mAzurkovic/foc/hw/foc_controller.kicad_pcb

## KiCad design hw/foc_controller.kicad_pcb (2026-10-27)

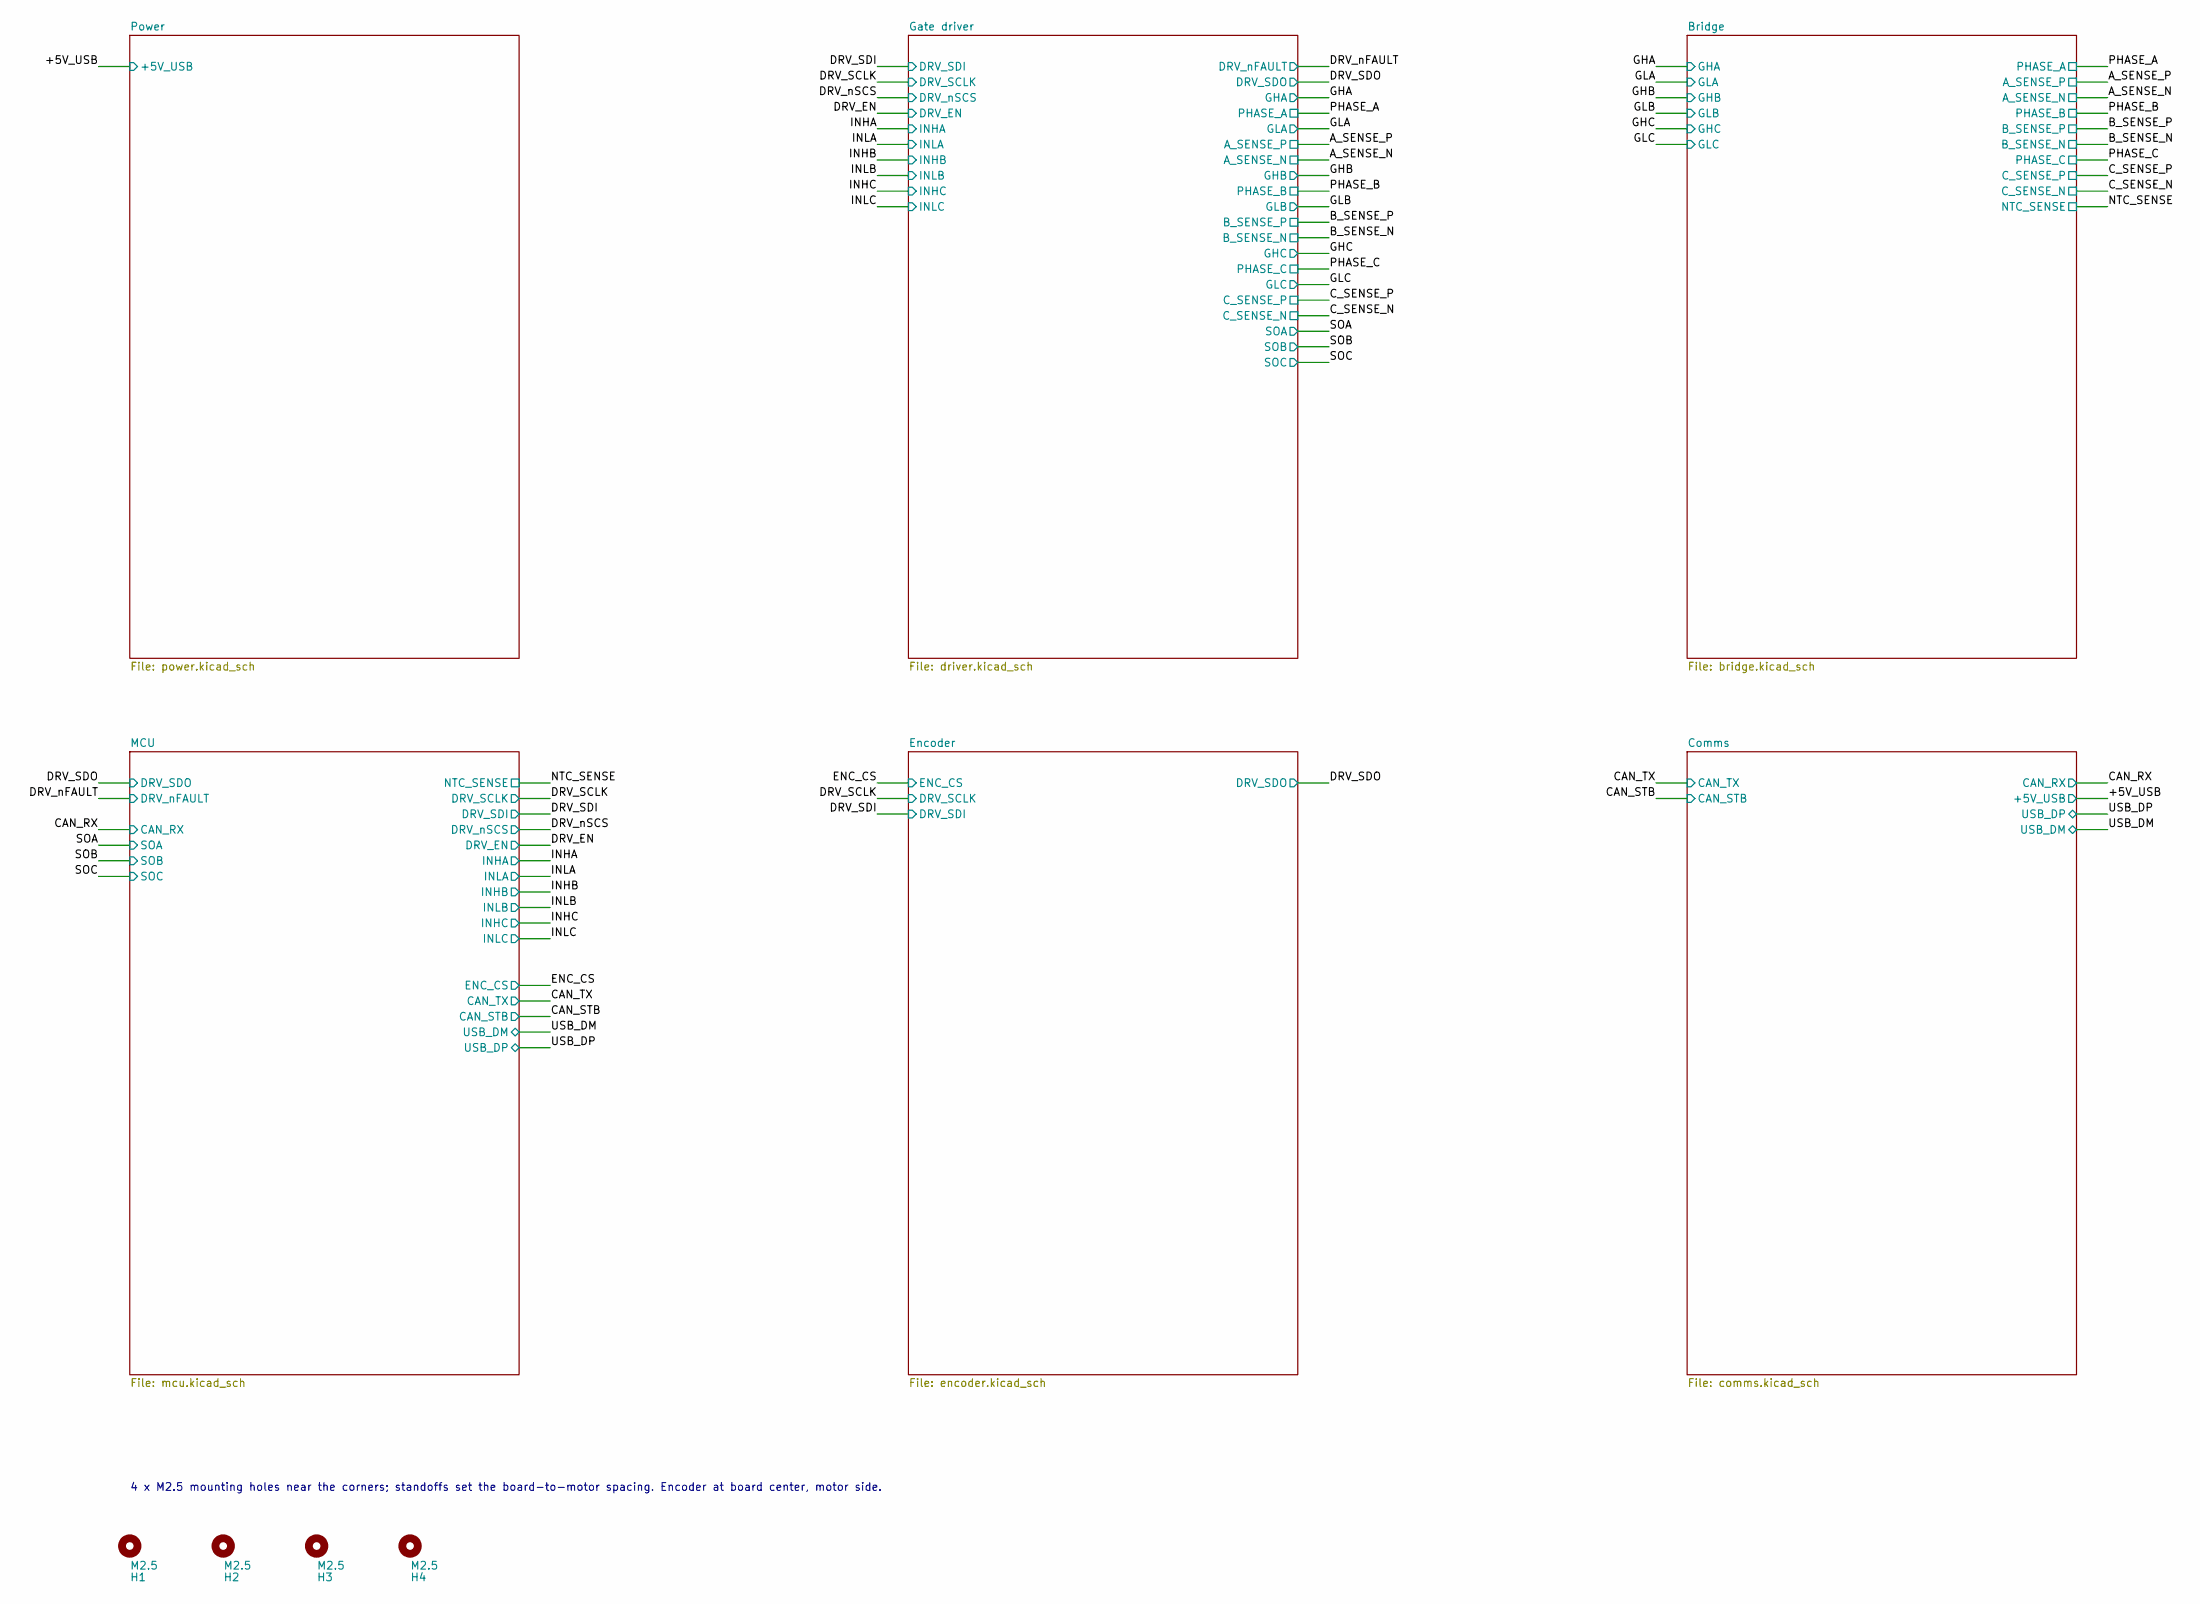
[picture p1: schematic foc_controller.kicad_sch, FOC controller: block diagram]

Parts:
H1, H2, H3, H4: M2.5; MountingHole_2.7mm_M2.5

Notes on the sheet:
4 x M2.5 mounting holes near the corners; standoffs set the board-to-motor spacing. Encoder at board center, motor side.

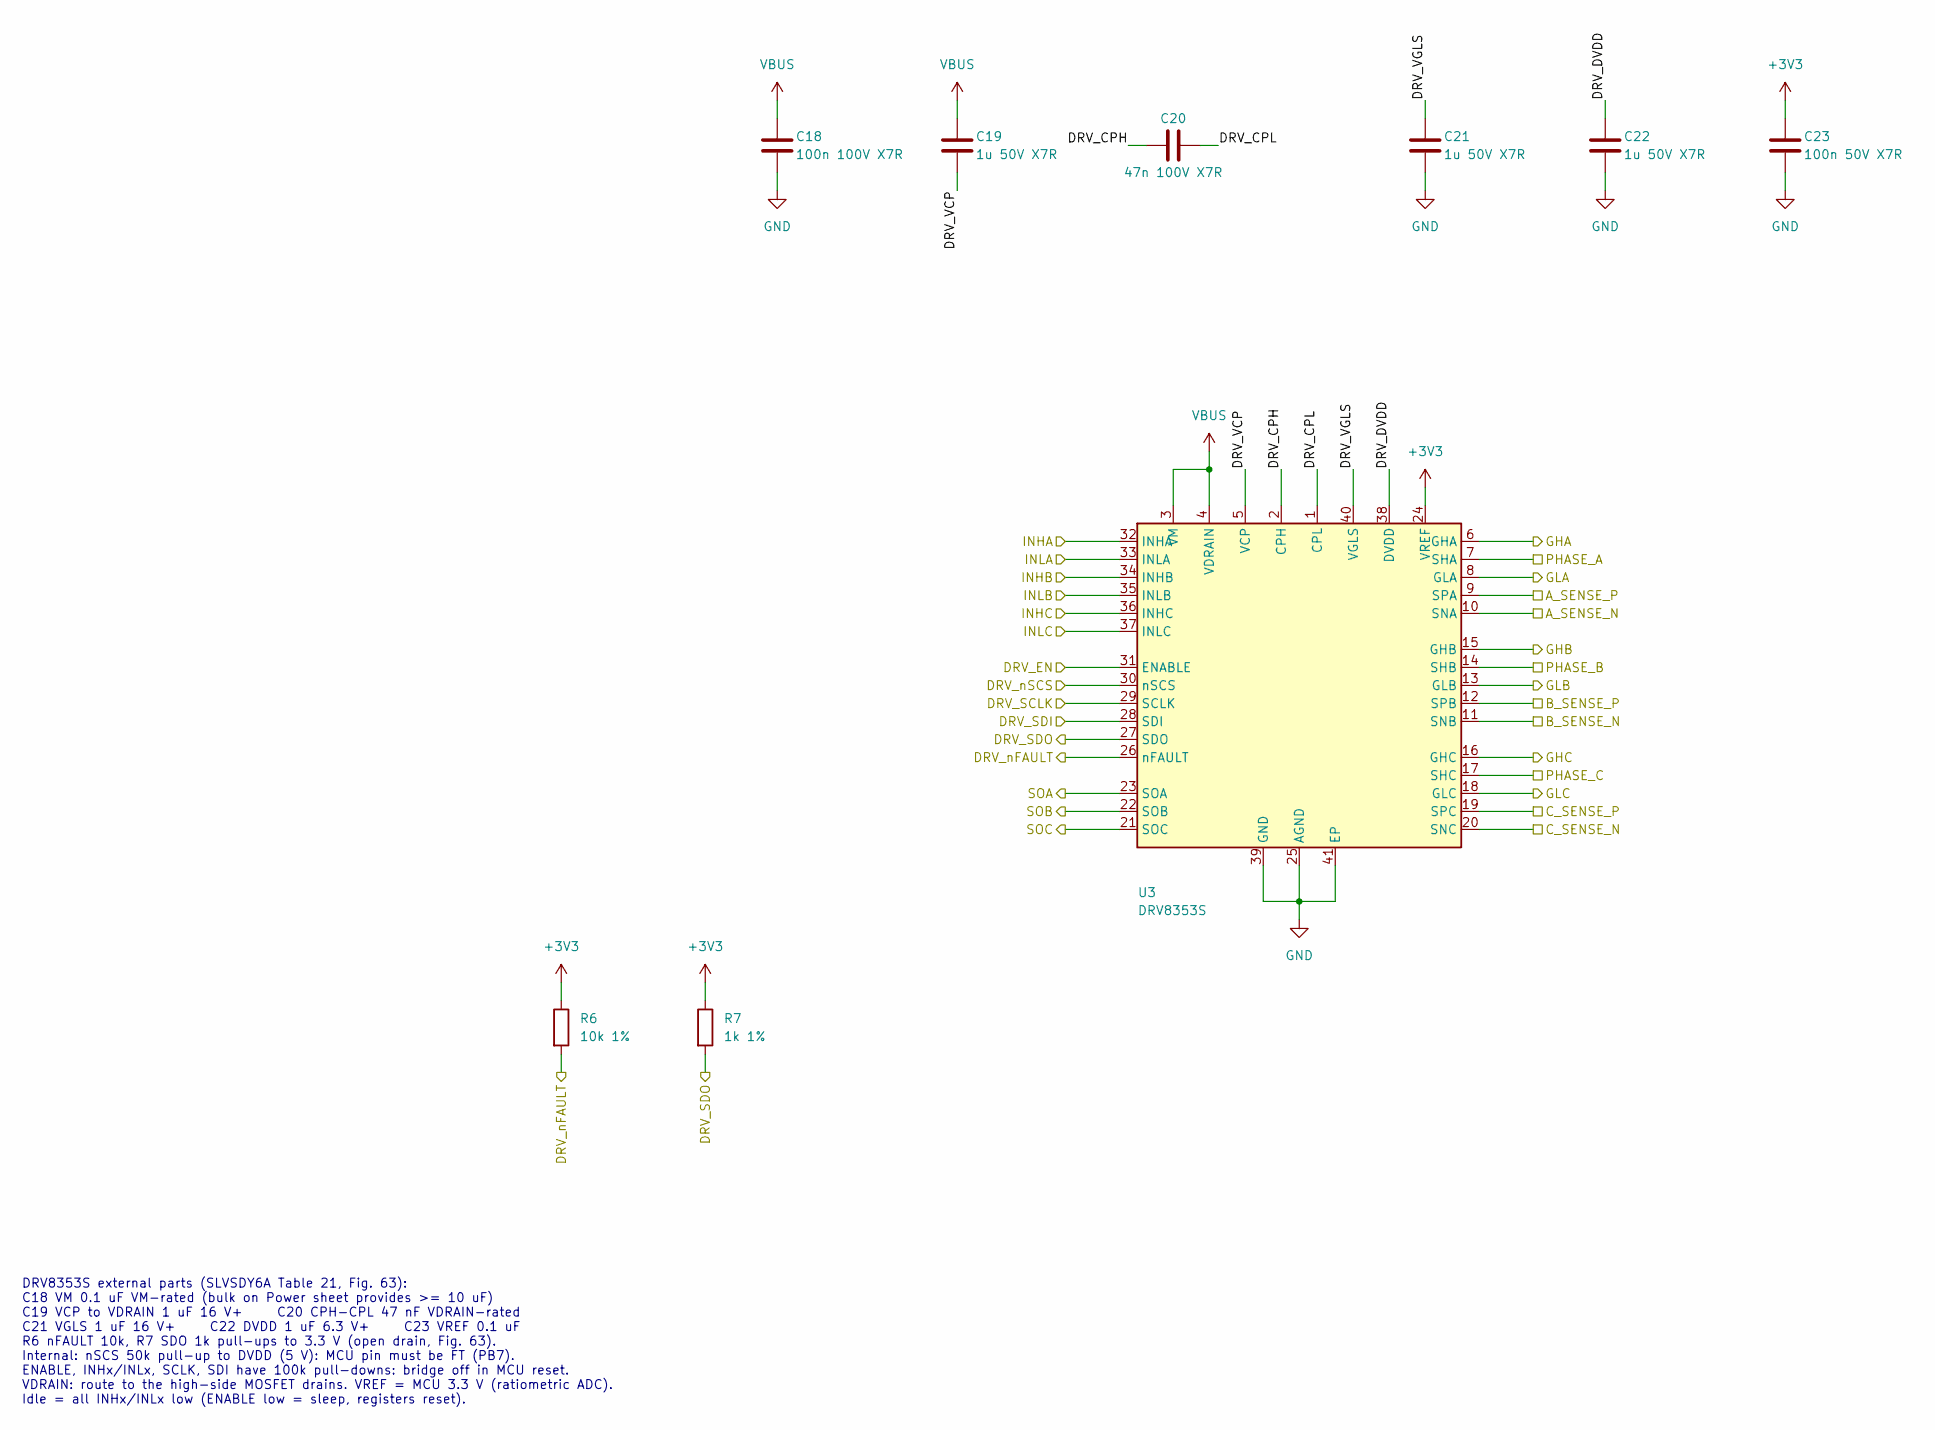
[picture p2: schematic driver.kicad_sch, Gate driver DRV8353S]

Parts:
C18: 100n 100V X7R; C_0603_1608Metric; MPN CC0603KRX7R0BB104; LCSC C113803
C19, C21, C22: 1u 50V X7R; C_0805_2012Metric; MPN CL21B105KBFNNNE; LCSC C28323
C20: 47n 100V X7R; C_0805_2012Metric; MPN CL21B473KCFNNNE; LCSC C17074
C23: 100n 50V X7R; C_0402_1005Metric; MPN CL05B104KB54PNC; LCSC C307331
R6: 10k 1%; R_0402_1005Metric; MPN 0402WGF1002TCE; LCSC C25744
R7: 1k 1%; R_0402_1005Metric; MPN 0402WGF1001TCE; LCSC C11702
U3: DRV8353S; WQFN-40_L6.0-W6.0-P0.50-TL-EP4.2; MPN DRV8353SRTAT; LCSC C2150480

Connections:
+3V3: C23.1, R6.1, R7.1, U3.24 (VREF); also elsewhere on the board
/A_SENSE_N: U3.10 (SNA); also elsewhere on the board
/A_SENSE_P: U3.9 (SPA); also elsewhere on the board
/B_SENSE_N: U3.11 (SNB); also elsewhere on the board
/B_SENSE_P: U3.12 (SPB); also elsewhere on the board
/C_SENSE_N: U3.20 (SNC); also elsewhere on the board
/C_SENSE_P: U3.19 (SPC); also elsewhere on the board
/DRV_EN: U3.31 (ENABLE); also elsewhere on the board
/DRV_SCLK: U3.29 (SCLK); also elsewhere on the board
/DRV_SDI: U3.28 (SDI); also elsewhere on the board
/DRV_SDO: R7.2, U3.27 (SDO); also elsewhere on the board
/DRV_nFAULT: R6.2, U3.26 (nFAULT); also elsewhere on the board
/DRV_nSCS: U3.30 (nSCS); also elsewhere on the board
/GHA: U3.6 (GHA); also elsewhere on the board
/GHB: U3.15 (GHB); also elsewhere on the board
/GHC: U3.16 (GHC); also elsewhere on the board
/GLA: U3.8 (GLA); also elsewhere on the board
/GLB: U3.13 (GLB); also elsewhere on the board
/GLC: U3.18 (GLC); also elsewhere on the board
/Gate driver/DRV_CPH: C20.1, U3.2 (CPH)
/Gate driver/DRV_CPL: C20.2, U3.1 (CPL)
/Gate driver/DRV_DVDD: C22.1, U3.38 (DVDD)
/Gate driver/DRV_VCP: C19.1, U3.5 (VCP)
/Gate driver/DRV_VGLS: C21.1, U3.40 (VGLS)
/INHA: U3.32 (INHA); also elsewhere on the board
/INHB: U3.34 (INHB); also elsewhere on the board
/INHC: U3.36 (INHC); also elsewhere on the board
/INLA: U3.33 (INLA); also elsewhere on the board
/INLB: U3.35 (INLB); also elsewhere on the board
/INLC: U3.37 (INLC); also elsewhere on the board
/PHASE_A: U3.7 (SHA); also elsewhere on the board
/PHASE_B: U3.14 (SHB); also elsewhere on the board
/PHASE_C: U3.17 (SHC); also elsewhere on the board
/SOA: U3.23 (SOA); also elsewhere on the board
/SOB: U3.22 (SOB); also elsewhere on the board
/SOC: U3.21 (SOC); also elsewhere on the board
GND: C18.2, C21.2, C22.2, C23.2, U3.25 (AGND), U3.39 (GND), U3.41 (EP); also elsewhere on the board
VBUS: C18.1, C19.2, U3.3 (VM), U3.4 (VDRAIN); also elsewhere on the board

Notes on the sheet:
DRV8353S external parts (SLVSDY6A Table 21, Fig. 63): C18 VM 0.1 uF VM-rated (bulk on Power sheet provides >= 10 uF) C19 VCP to VDRAIN 1 uF 16 V+ C20 CPH-CPL 47 nF VDRAIN-rated C21 VGLS 1 uF 16 V+ C22 DVDD 1 uF 6.3 V+ C23 VREF 0.1 uF R6 nFAULT 10k, R7 SDO 1k pull-ups to 3.3 V (open drain, Fig. 63).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

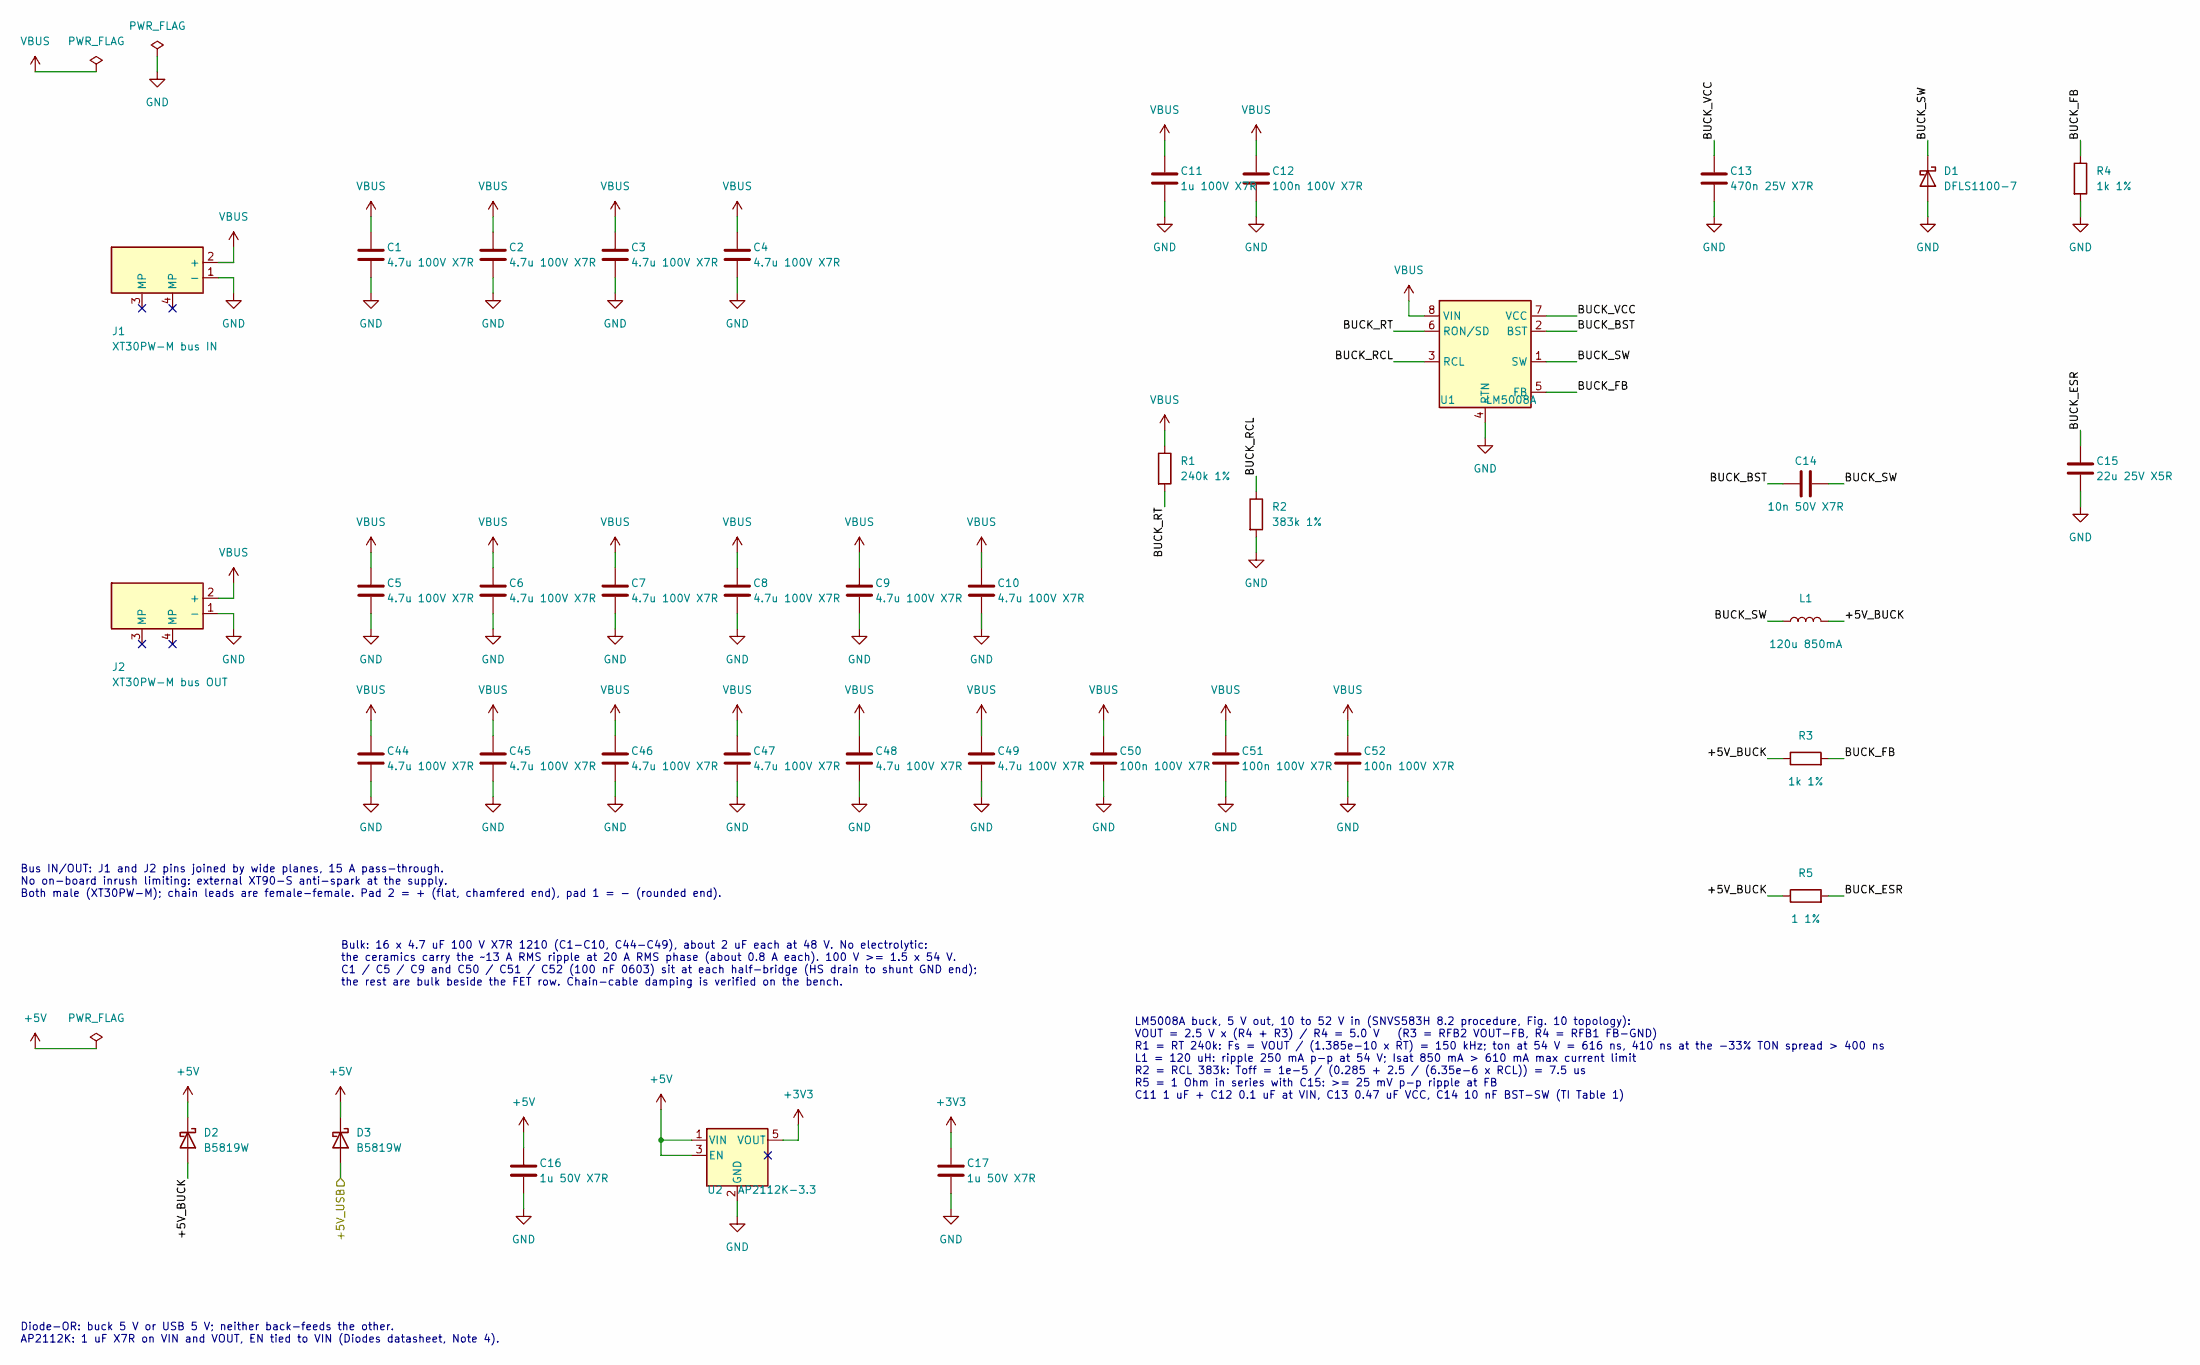
[picture p3: schematic power.kicad_sch, Power input, bulk capacitance, logic supply]

Parts:
C1, C2, C3, C4, C5, C6, C7, C8, C9, C10, C44, C45, C46, C47, C48, C49: 4.7u 100V X7R; C_1210_3225Metric; MPN FS32X475K101EGG; LCSC C381466
C11: 1u 100V X7R; C_1206_3216Metric; MPN CC1206KKX7R0BB105; LCSC C70463
C12, C50, C51, C52: 100n 100V X7R; C_0603_1608Metric; MPN CC0603KRX7R0BB104; LCSC C113803
C13: 470n 25V X7R; C_0603_1608Metric; MPN CL10B474KA8NNNC; LCSC C1623
C14: 10n 50V X7R; C_0603_1608Metric; MPN 0603B103K500NT; LCSC C57112
C15: 22u 25V X5R; C_1206_3216Metric; MPN CL31A226KAHNNNE; LCSC C12891
C16, C17: 1u 50V X7R; C_0805_2012Metric; MPN CL21B105KBFNNNE; LCSC C28323
D1: DFLS1100-7; D_PowerDI-123; MPN DFLS1100-7; LCSC C107674
D2, D3: B5819W; D_SOD-123; MPN B5819W SL; LCSC C8598
J1: XT30PW-M bus IN; CONN-TH_XT30PW-M-1; MPN XT30PW-M30.G.Y; LCSC C431092
J2: XT30PW-M bus OUT; CONN-TH_XT30PW-M-1; MPN XT30PW-M30.G.Y; LCSC C431092
L1: 120u 850mA; IND-SMD_L6.0-W6.0; MPN SWPA6045S121MT; LCSC C96952
R1: 240k 1%; R_0603_1608Metric; MPN RC0603FR-07240KL; LCSC C137765
R2: 383k 1%; R_0603_1608Metric; MPN 0603WAF3833T5E; LCSC C25816
R3, R4: 1k 1%; R_0402_1005Metric; MPN 0402WGF1001TCE; LCSC C11702
R5: 1 1%; R_0603_1608Metric; MPN 0603WAF100KT5E; LCSC C22936
U1: LM5008A; MSOP-8_3x3mm_P0.65mm; MPN LM5008AMMX/NOPB; LCSC C2071250
U2: AP2112K-3.3; SOT-23-5; MPN AP2112K-3.3TRG1; LCSC C51118

Connections:
+3V3: C17.1, U2.5 (VOUT); also elsewhere on the board
+5V: C16.1, D2.1 (K), D3.1 (K), U2.1 (VIN), U2.3 (EN)
/+5V_USB: D3.2 (A); also elsewhere on the board
/Power/+5V_BUCK: D2.2 (A), L1.2, R3.1, R5.1
/Power/BUCK_BST: C14.1, U1.2 (BST)
/Power/BUCK_ESR: C15.1, R5.2
/Power/BUCK_FB: R3.2, R4.1, U1.5 (FB)
/Power/BUCK_RCL: R2.1, U1.3 (RCL)
/Power/BUCK_RT: R1.2, U1.6 (RON/SD)
/Power/BUCK_SW: C14.2, D1.1 (K), L1.1, U1.1 (SW)
/Power/BUCK_VCC: C13.1, U1.7 (VCC)
GND: C1.2, C2.2, C3.2, C4.2, C5.2, C6.2, C7.2, C8.2, C9.2, C10.2, C11.2, C12.2, C13.2, C15.2, C16.2, C17.2, C44.2, C45.2, C46.2, C47.2, C48.2, C49.2, C50.2, C51.2, C52.2, D1.2 (A), J1.1 (-), J2.1 (-), R2.2, R4.2, U1.4 (RTN), U2.2 (GND); also elsewhere on the board
VBUS: C1.1, C2.1, C3.1, C4.1, C5.1, C6.1, C7.1, C8.1, C9.1, C10.1, C11.1, C12.1, C44.1, C45.1, C46.1, C47.1, C48.1, C49.1, C50.1, C51.1, C52.1, J1.2 (+), J2.2 (+), R1.1, U1.8 (VIN); also elsewhere on the board

Notes on the sheet:
Diode-OR: buck 5 V or USB 5 V; neither back-feeds the other. AP2112K: 1 uF X7R on VIN and VOUT, EN tied to VIN (Diodes datasheet, Note 4).
Bus IN/OUT: J1 and J2 pins joined by wide planes, 15 A pass-through. No on-board inrush limiting: external XT90-S anti-spark at the supply. Both male (XT30PW-M); chain leads are female-female. Pad 2 = + (flat, chamfered end), pad 1 = - (rounded end).
LM5008A buck, 5 V out, 10 to 52 V in (SNVS583H 8.2 procedure, Fig. 10 topology): VOUT = 2.5 V x (R4 + R3) / R4 = 5.0 V (R3 = RFB2 VOUT-FB, R4 = RFB1 FB-GND) R1 = RT 240k: Fs = VOUT / (1.385e-10 x RT) = 150 kHz; ton at 54 V = 616 ns, 410 ns at the -33% TON spread > 400 ns L1 = 120 uH: ripple 250 mA 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
Bulk: 16 x 4.7 uF 100 V X7R 1210 (C1-C10, C44-C49), about 2 uF each at 48 V. No electrolytic: the ceramics carry the ~13 A RMS ripple at 20 A RMS phase (about 0.8 A each). 100 V >= 1.5 x 54 V. C1 / C5 / C9 and C50 / C51 / C52 (100 nF 0603) sit at each half-bridge (HS drain to shunt GND end); the re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

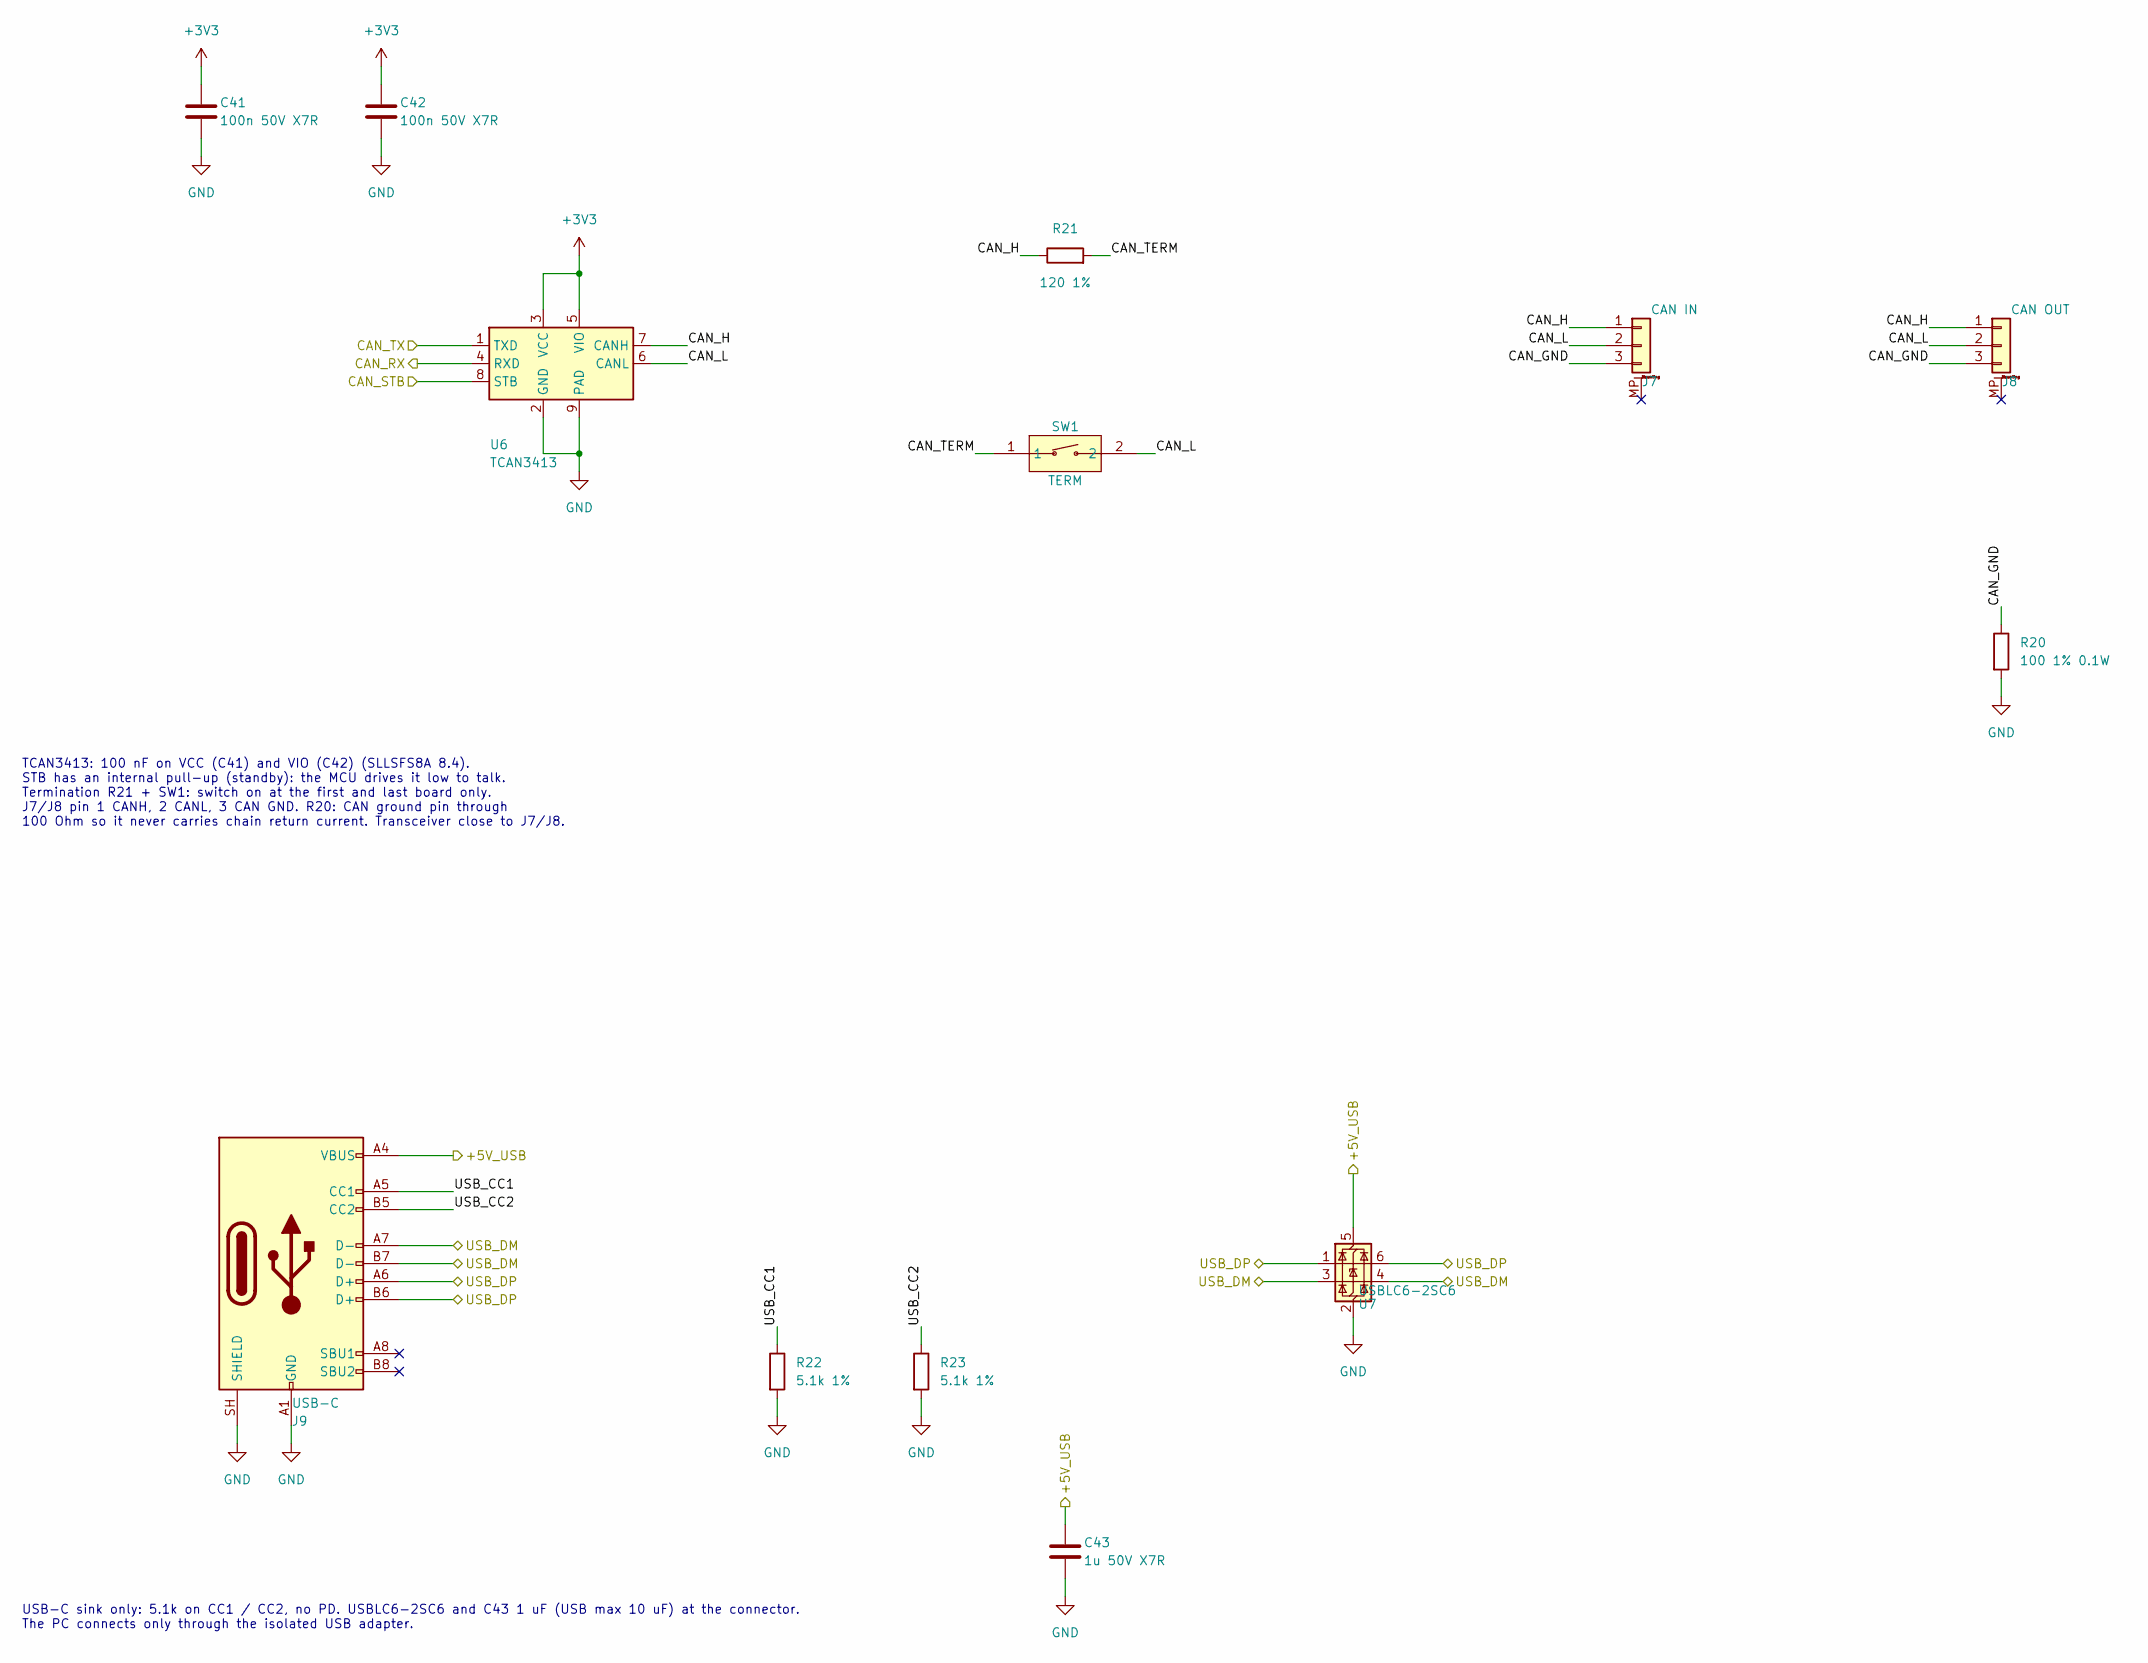
[picture p4: schematic comms.kicad_sch, CAN FD daisy chain and USB-C]

Parts:
C41, C42: 100n 50V X7R; C_0402_1005Metric; MPN CL05B104KB54PNC; LCSC C307331
C43: 1u 50V X7R; C_0805_2012Metric; MPN CL21B105KBFNNNE; LCSC C28323
J7: CAN IN; JST_GH_SM03B-GHS-TB_1x03-1MP_P1.25mm_Horizontal; MPN SM03B-GHS-TB(LF)(SN); LCSC C514175
J8: CAN OUT; JST_GH_SM03B-GHS-TB_1x03-1MP_P1.25mm_Horizontal; MPN SM03B-GHS-TB(LF)(SN); LCSC C514175
J9: USB-C; USB_C_Receptacle_HRO_TYPE-C-31-M-12; MPN TYPE-C-31-M-12; LCSC C165948
R20: 100 1% 0.1W; R_0603_1608Metric; MPN 0603WAF1000T5E; LCSC C22775
R21: 120 1%; R_0603_1608Metric; MPN 0603WAF1200T5E; LCSC C22787
R22, R23: 5.1k 1%; R_0402_1005Metric; MPN 0402WGF5101TCE; LCSC C25905
SW1: TERM; SW-SMD_1.27-1P-TPPT; MPN 1.27-1P TPPT; LCSC C6386918
U6: TCAN3413; SON-8_L3.0-W3.0-P0.65-LS2.9-BL-EP; MPN TCAN3413DRBR; LCSC C22445415
U7: USBLC6-2SC6; SOT-23-6; MPN USBLC6-2SC6; LCSC C2687116

Connections:
+3V3: C41.1, C42.1, U6.3 (VCC), U6.5 (VIO); also elsewhere on the board
/+5V_USB: C43.1, J9.A4 (VBUS), J9.A9 (VBUS), J9.B4 (VBUS), J9.B9 (VBUS), U7.5 (VBUS); also elsewhere on the board
/CAN_RX: U6.4 (RXD); also elsewhere on the board
/CAN_STB: U6.8 (STB); also elsewhere on the board
/CAN_TX: U6.1 (TXD); also elsewhere on the board
/Comms/CAN_GND: J7.3, J8.3, R20.1; also elsewhere on the board
/Comms/CAN_H: J7.1, J8.1, R21.1, U6.7 (CANH); also elsewhere on the board
/Comms/CAN_L: J7.2, J8.2, SW1.2, U6.6 (CANL); also elsewhere on the board
/Comms/USB_CC1: J9.A5 (CC1), R22.1
/Comms/USB_CC2: J9.B5 (CC2), R23.1
/USB_DM: J9.A7 (D-), J9.B7 (D-), U7.3 (I/O2), U7.4 (I/O2); also elsewhere on the board
/USB_DP: J9.A6 (D+), J9.B6 (D+), U7.1 (I/O1), U7.6 (I/O1); also elsewhere on the board
GND: C41.2, C42.2, C43.2, J9.A1 (GND), J9.A12 (GND), J9.B1 (GND), J9.B12 (GND), J9.SH (SHIELD), R20.2, R22.2, R23.2, U6.2 (GND), U6.9 (PAD), U7.2 (GND); also elsewhere on the board
unnamed: R21.2, SW1.1

Notes on the sheet:
TCAN3413: 100 nF on VCC (C41) and VIO (C42) (SLLSFS8A 8.4). STB has an internal pull-up (standby): the MCU drives it low to talk. Termination R21 + SW1: switch on at the first and last board only. J7/J8 pin 1 CANH, 2 CANL, 3 CAN GND. R20: CAN ground pin through 100 Ohm so it never carries chain ret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
USB-C sink only: 5.1k on CC1 / CC2, no PD. USBLC6-2SC6 and C43 1 uF (USB max 10 uF) at the connector. The PC connects only through the isolated USB adapter.

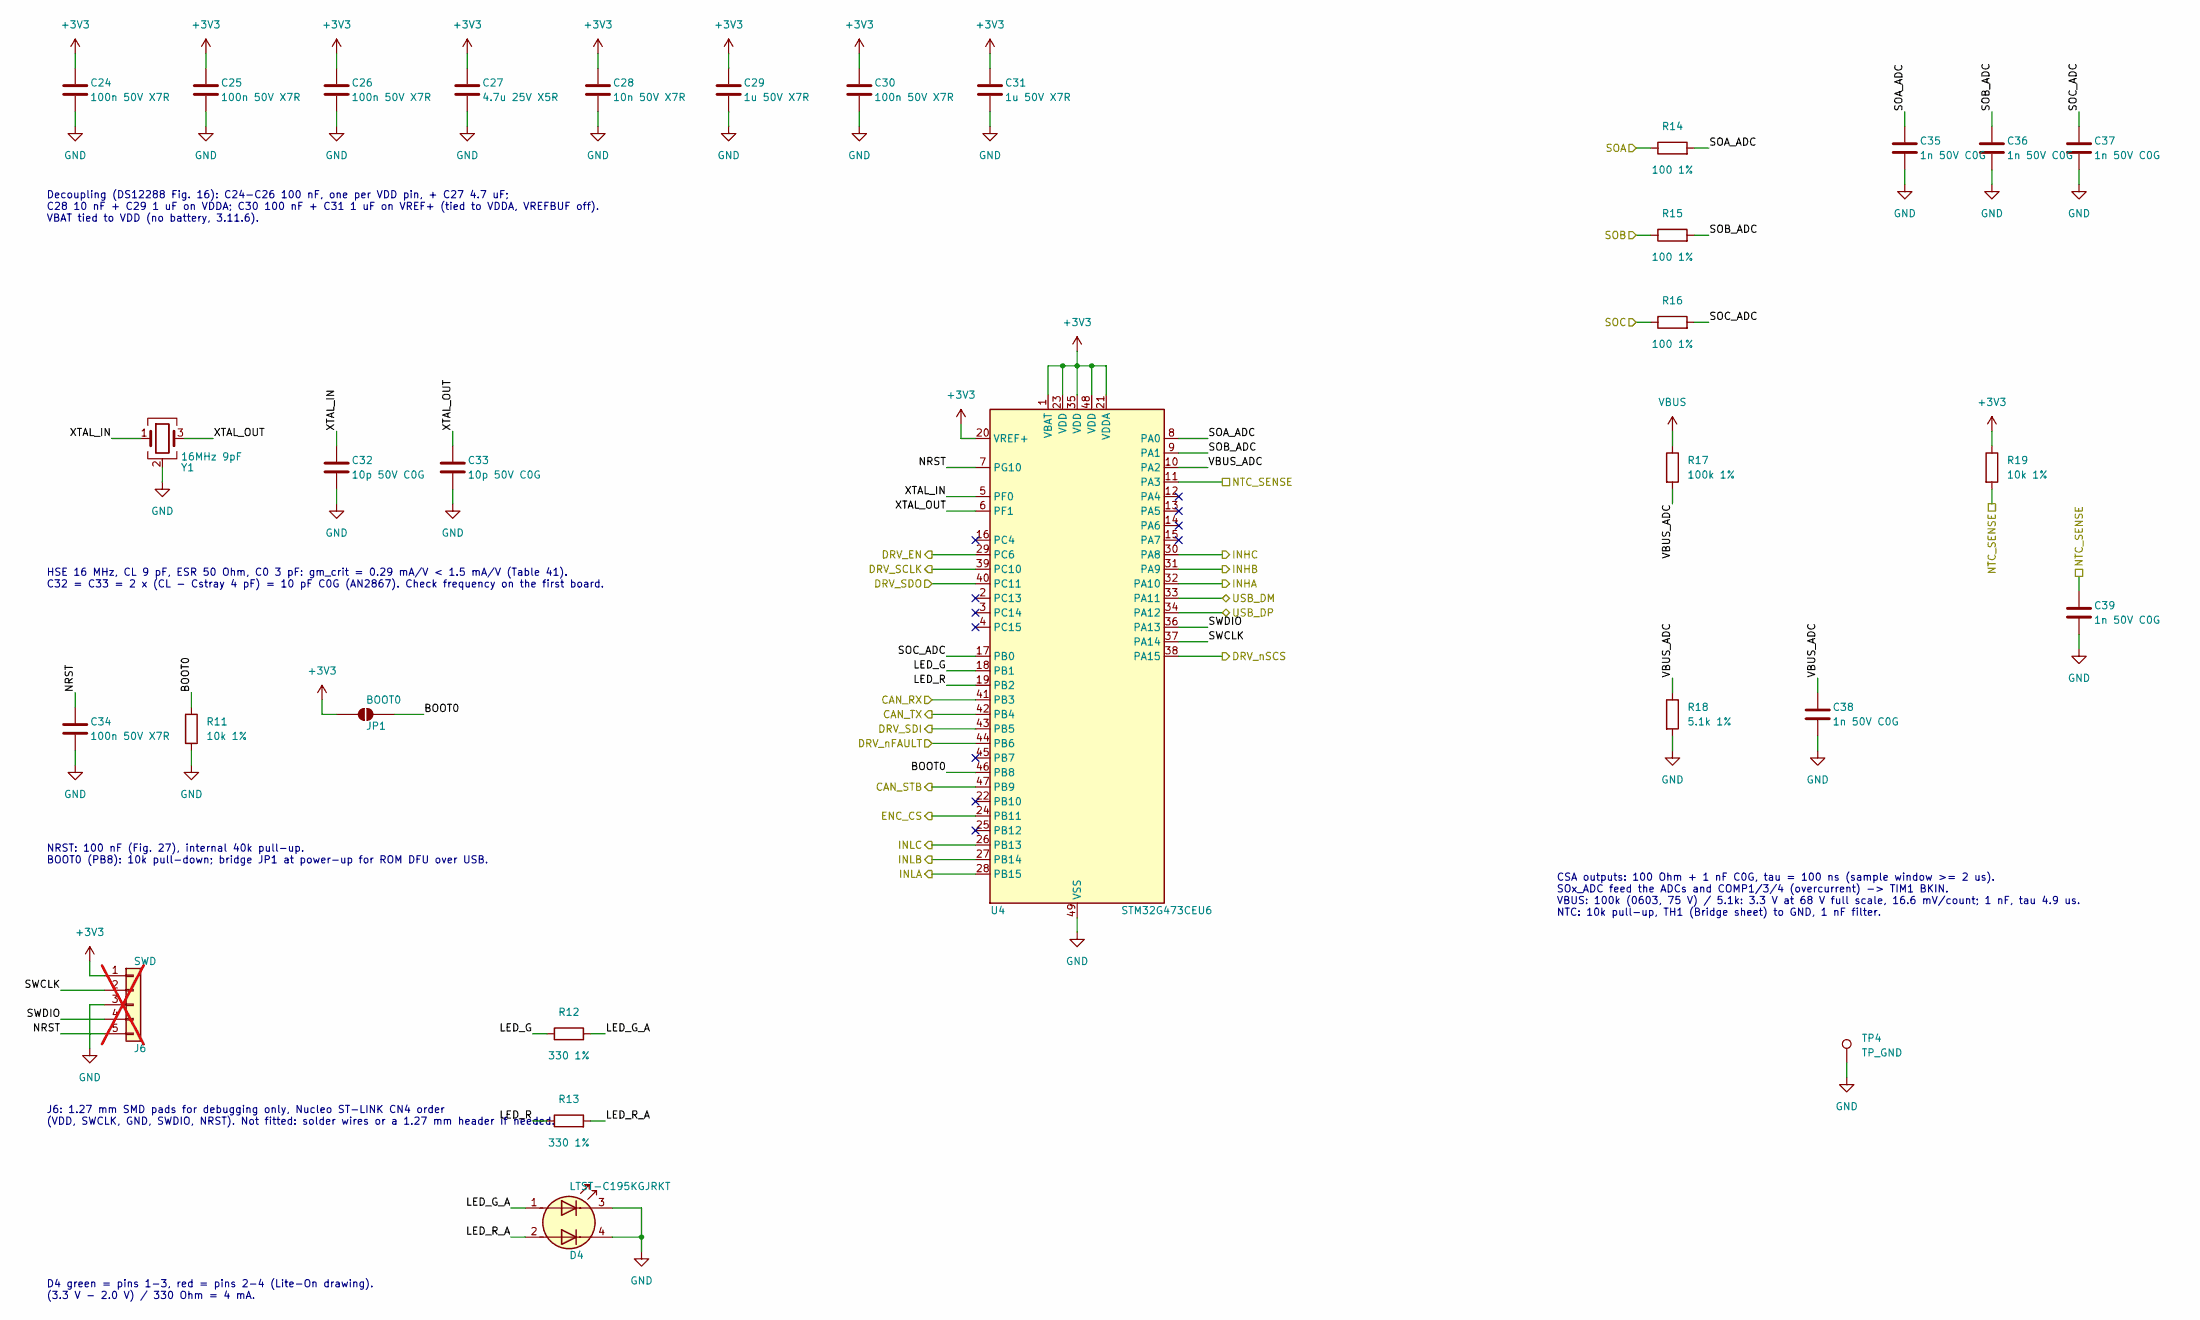
[picture p5: schematic mcu.kicad_sch, MCU STM32G473]

Parts:
C24, C25, C26, C30, C34: 100n 50V X7R; C_0402_1005Metric; MPN CL05B104KB54PNC; LCSC C307331
C27: 4.7u 25V X5R; C_0805_2012Metric; MPN CL21A475KAQNNNE; LCSC C1779
C28: 10n 50V X7R; C_0402_1005Metric; MPN CL05B103KB5NNNC; LCSC C15195
C29, C31: 1u 50V X7R; C_0805_2012Metric; MPN CL21B105KBFNNNE; LCSC C28323
C32, C33: 10p 50V C0G; C_0402_1005Metric; MPN CL05C100JB5NNNC; LCSC C32949
C35, C36, C37, C38, C39: 1n 50V C0G; C_0402_1005Metric; MPN CC0402JRNPO9BN102; LCSC C113780
D4: LTST-C195KGJRKT; LED-ARRAY-SMD_0603-4P-L1.6-W1.5-BR-RD; MPN LTST-C195KGJRKT; LCSC C125104
J6: SWD; SWD_Pads_1x05_P1.27mm_SMD; not fitted
JP1: BOOT0; SolderJumper-2_P1.3mm_Open_Pad1.0x1.5mm
R11, R19: 10k 1%; R_0402_1005Metric; MPN 0402WGF1002TCE; LCSC C25744
R12, R13: 330 1%; R_0402_1005Metric; MPN 0402WGF3300TCE; LCSC C25104
R14, R15, R16: 100 1%; R_0402_1005Metric; MPN 0402WGF1000TCE; LCSC C25076
R17: 100k 1%; R_0603_1608Metric; MPN 0603WAF1003T5E; LCSC C25803
R18: 5.1k 1%; R_0603_1608Metric; MPN 0603WAF5101T5E; LCSC C23186
TP4: TP_GND; TestPoint_Pad_D1.0mm
U4: STM32G473CEU6; QFN-48-1EP_7x7mm_P0.5mm_EP5.6x5.6mm; MPN STM32G473CEU6; LCSC C1342773
Y1: 16MHz 9pF; Crystal_SMD_3225-4Pin_3.2x2.5mm; MPN X322516MLB4SI; LCSC C13738

Connections:
+3V3: C24.1, C25.1, C26.1, C27.1, C28.1, C29.1, C30.1, C31.1, J6.1, JP1.1 (A), R19.1, U4.1 (VBAT), U4.20 (VREF+), U4.21 (VDDA), U4.23 (VDD), U4.35 (VDD), U4.48 (VDD); also elsewhere on the board
/CAN_RX: U4.41 (PB3); also elsewhere on the board
/CAN_STB: U4.47 (PB9); also elsewhere on the board
/CAN_TX: U4.42 (PB4); also elsewhere on the board
/DRV_EN: U4.29 (PC6); also elsewhere on the board
/DRV_SCLK: U4.39 (PC10); also elsewhere on the board
/DRV_SDI: U4.43 (PB5); also elsewhere on the board
/DRV_SDO: U4.40 (PC11); also elsewhere on the board
/DRV_nFAULT: U4.44 (PB6); also elsewhere on the board
/DRV_nSCS: U4.38 (PA15); also elsewhere on the board
/ENC_CS: U4.24 (PB11); also elsewhere on the board
/INHA: U4.32 (PA10); also elsewhere on the board
/INHB: U4.31 (PA9); also elsewhere on the board
/INHC: U4.30 (PA8); also elsewhere on the board
/INLA: U4.28 (PB15); also elsewhere on the board
/INLB: U4.27 (PB14); also elsewhere on the board
/INLC: U4.26 (PB13); also elsewhere on the board
/MCU/BOOT0: JP1.2 (B), R11.1, U4.46 (PB8)
/MCU/LED_G: R12.1, U4.18 (PB1)
/MCU/LED_G_A: D4.1 (A1), R12.2
/MCU/LED_R: R13.1, U4.19 (PB2)
/MCU/LED_R_A: D4.2 (A2), R13.2
/MCU/NRST: C34.1, J6.5, U4.7 (PG10); also elsewhere on the board
/MCU/SOA_ADC: C35.1, R14.2, U4.8 (PA0)
/MCU/SOB_ADC: C36.1, R15.2, U4.9 (PA1)
/MCU/SOC_ADC: C37.1, R16.2, U4.17 (PB0)
/MCU/SWCLK: J6.2, U4.37 (PA14); also elsewhere on the board
/MCU/SWDIO: J6.4, U4.36 (PA13); also elsewhere on the board
/MCU/VBUS_ADC: C38.1, R17.2, R18.1, U4.10 (PA2)
/MCU/XTAL_IN: C32.1, U4.5 (PF0), Y1.1
/MCU/XTAL_OUT: C33.1, U4.6 (PF1), Y1.3
/NTC_SENSE: C39.1, R19.2, U4.11 (PA3); also elsewhere on the board
/SOA: R14.1; also elsewhere on the board
/SOB: R15.1; also elsewhere on the board
/SOC: R16.1; also elsewhere on the board
/USB_DM: U4.33 (PA11); also elsewhere on the board
/USB_DP: U4.34 (PA12); also elsewhere on the board
GND: C24.2, C25.2, C26.2, C27.2, C28.2, C29.2, C30.2, C31.2, C32.2, C33.2, C34.2, C35.2, C36.2, C37.2, C38.2, C39.2, D4.3 (K1), D4.4 (K2), J6.3, R11.2, R18.2, TP4.1 (1_1), U4.49 (VSS), Y1.2 (G), Y1.4 (G); also elsewhere on the board
VBUS: R17.1; also elsewhere on the board

Notes on the sheet:
Decoupling (DS12288 Fig. 16): C24-C26 100 nF, one per VDD pin, + C27 4.7 uF; C28 10 nF + C29 1 uF on VDDA; C30 100 nF + C31 1 uF on VREF+ (tied to VDDA, VREFBUF off). VBAT tied to VDD (no battery, 3.11.6).
HSE 16 MHz, CL 9 pF, ESR 50 Ohm, C0 3 pF: gm_crit = 0.29 mA/V < 1.5 mA/V (Table 41). C32 = C33 = 2 x (CL - Cstray 4 pF) = 10 pF C0G (AN2867). Check frequency on the first board.
CSA outputs: 100 Ohm + 1 nF C0G, tau = 100 ns (sample window >= 2 us). SOx_ADC feed the ADCs and COMP1/3/4 (overcurrent) -> TIM1 BKIN. VBUS: 100k (0603, 75 V) / 5.1k: 3.3 V at 68 V full scale, 16.6 mV/count; 1 nF, tau 4.9 us. NTC: 10k pull-up, TH1 (Bridge sheet) to GND, 1 nF filter.
D4 green = pins 1-3, red = pins 2-4 (Lite-On drawing). (3.3 V - 2.0 V) / 330 Ohm = 4 mA.
J6: 1.27 mm SMD pads for debugging only, Nucleo ST-LINK CN4 order (VDD, SWCLK, GND, SWDIO, NRST). Not fitted: solder wires or a 1.27 mm header if needed.
NRST: 100 nF (Fig. 27), internal 40k pull-up. BOOT0 (PB8): 10k pull-down; bridge JP1 at power-up for ROM DFU over USB.
