mAzurkovic/foc/hw/foc_controller.kicad_pcb

## KiCad design hw/foc_controller.kicad_pcb (continued)

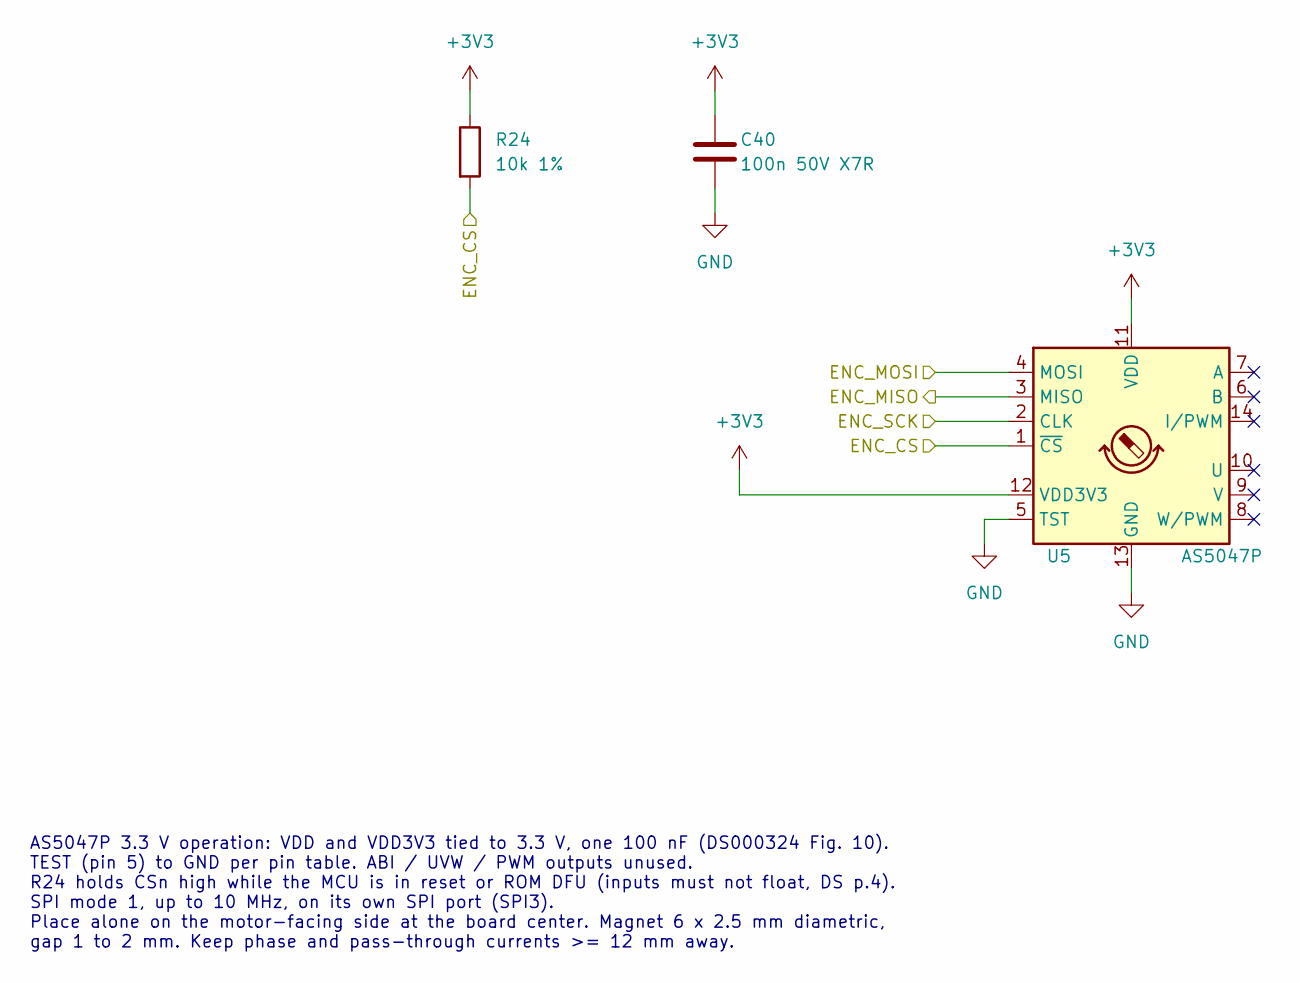
[picture p6: schematic encoder.kicad_sch, Magnetic encoder AS5047P (motor-facing side)]

Parts:
C40: 100n 50V X7R; C_0402_1005Metric; MPN CL05B104KB54PNC; LCSC C307331
R24: 10k 1%; R_0402_1005Metric; MPN 0402WGF1002TCE; LCSC C25744
U5: AS5047P; TSSOP-14_4.4x5mm_P0.65mm; MPN AS5047P-ATSM; LCSC C962063

Connections:
+3V3: C40.1, R24.1, U5.11 (VDD), U5.12 (VDD3V3); also elsewhere on the board
/DRV_SCLK: U5.2 (CLK); also elsewhere on the board
/DRV_SDI: U5.4 (MOSI); also elsewhere on the board
/DRV_SDO: U5.3 (MISO); also elsewhere on the board
/ENC_CS: R24.2, U5.1 (~CS); also elsewhere on the board
GND: C40.2, U5.5 (TST), U5.13 (GND); also elsewhere on the board

Notes on the sheet:
AS5047P 3.3 V operation: VDD and VDD3V3 tied to 3.3 V, one 100 nF (DS000324 Fig. 10). TEST (pin 5) to GND per pin table. ABI / UVW / PWM outputs unused. R24 holds CSn high while the MCU is in reset or ROM DFU (inputs must not float, DS p.4). SPI mode 1, up to 10 MHz, on its own SPI port (SPI3). Pla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

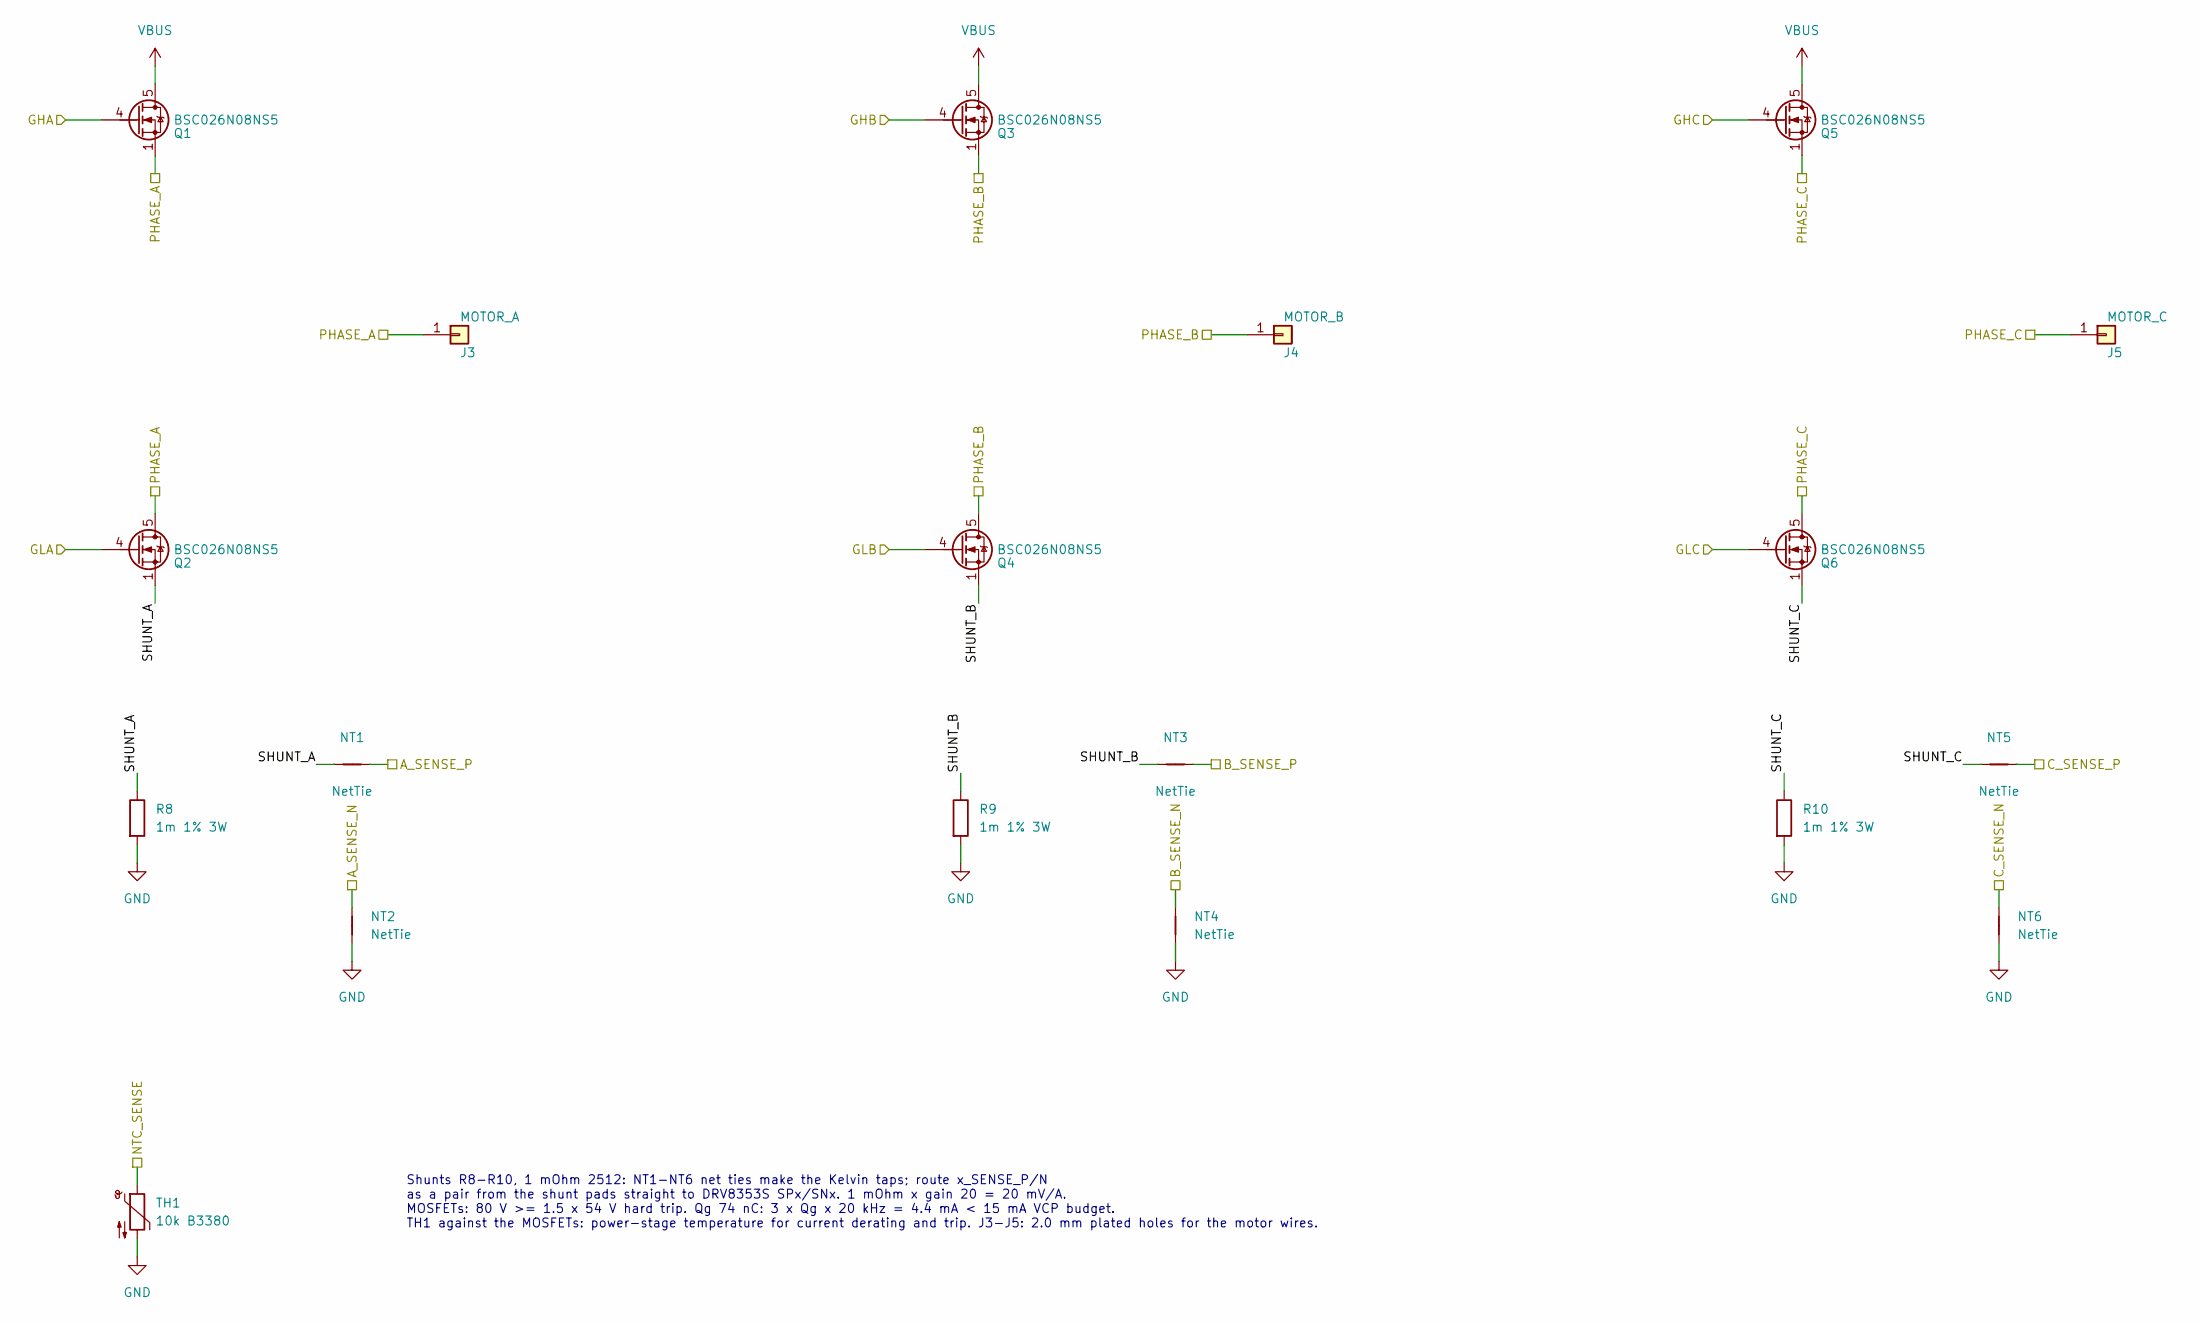
[picture p7: schematic bridge.kicad_sch, Three-phase bridge, shunts, motor outputs]

Parts:
J3: MOTOR_A; SolderWire-2sqmm_1x01_D2mm_OD3.9mm
J4: MOTOR_B; SolderWire-2sqmm_1x01_D2mm_OD3.9mm
J5: MOTOR_C; SolderWire-2sqmm_1x01_D2mm_OD3.9mm
NT1, NT2, NT3, NT4, NT5, NT6: NetTie; NetTie-2_SMD_Pad0.5mm
Q1, Q2, Q3, Q4, Q5, Q6: BSC026N08NS5; Infineon_PG-TDSON-8_6.15x5.15mm; MPN BSC026N08NS5ATMA1; LCSC C5955453
R8, R9, R10: 1m 1% 3W; R_2512_6332Metric; MPN HoJLR2512-3W-1mR-1%; LCSC C2903470
TH1: 10k B3380; R_0402_1005Metric; MPN NCP15XH103F03RC; LCSC C77131

Connections:
/A_SENSE_N: NT2.2; also elsewhere on the board
/A_SENSE_P: NT1.2; also elsewhere on the board
/B_SENSE_N: NT4.2; also elsewhere on the board
/B_SENSE_P: NT3.2; also elsewhere on the board
/Bridge/SHUNT_A: NT1.1, Q2.1 (S), Q2.2 (S), Q2.3 (S), R8.1
/Bridge/SHUNT_B: NT3.1, Q4.1 (S), Q4.2 (S), Q4.3 (S), R9.1
/Bridge/SHUNT_C: NT5.1, Q6.1 (S), Q6.2 (S), Q6.3 (S), R10.1
/C_SENSE_N: NT6.2; also elsewhere on the board
/C_SENSE_P: NT5.2; also elsewhere on the board
/GHA: Q1.4 (G); also elsewhere on the board
/GHB: Q3.4 (G); also elsewhere on the board
/GHC: Q5.4 (G); also elsewhere on the board
/GLA: Q2.4 (G); also elsewhere on the board
/GLB: Q4.4 (G); also elsewhere on the board
/GLC: Q6.4 (G); also elsewhere on the board
/NTC_SENSE: TH1.1; also elsewhere on the board
/PHASE_A: J3.1, Q1.1 (S), Q1.2 (S), Q1.3 (S), Q2.5 (D); also elsewhere on the board
/PHASE_B: J4.1, Q3.1 (S), Q3.2 (S), Q3.3 (S), Q4.5 (D); also elsewhere on the board
/PHASE_C: J5.1, Q5.1 (S), Q5.2 (S), Q5.3 (S), Q6.5 (D); also elsewhere on the board
GND: NT2.1, NT4.1, NT6.1, R8.2, R9.2, R10.2, TH1.2; also elsewhere on the board
VBUS: Q1.5 (D), Q3.5 (D), Q5.5 (D); also elsewhere on the board

Notes on the sheet:
Shunts R8-R10, 1 mOhm 2512: NT1-NT6 net ties make the Kelvin taps; route x_SENSE_P/N as a pair from the shunt pads straight to DRV8353S SPx/SNx. 1 mOhm x gain 20 = 20 mV/A. MOSFETs: 80 V >= 1.5 x 54 V hard trip. Qg 74 nC: 3 x Qg x 20 kHz = 4.4 mA < 15 mA VCP budget. TH1 against the MOSFETs: power-s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

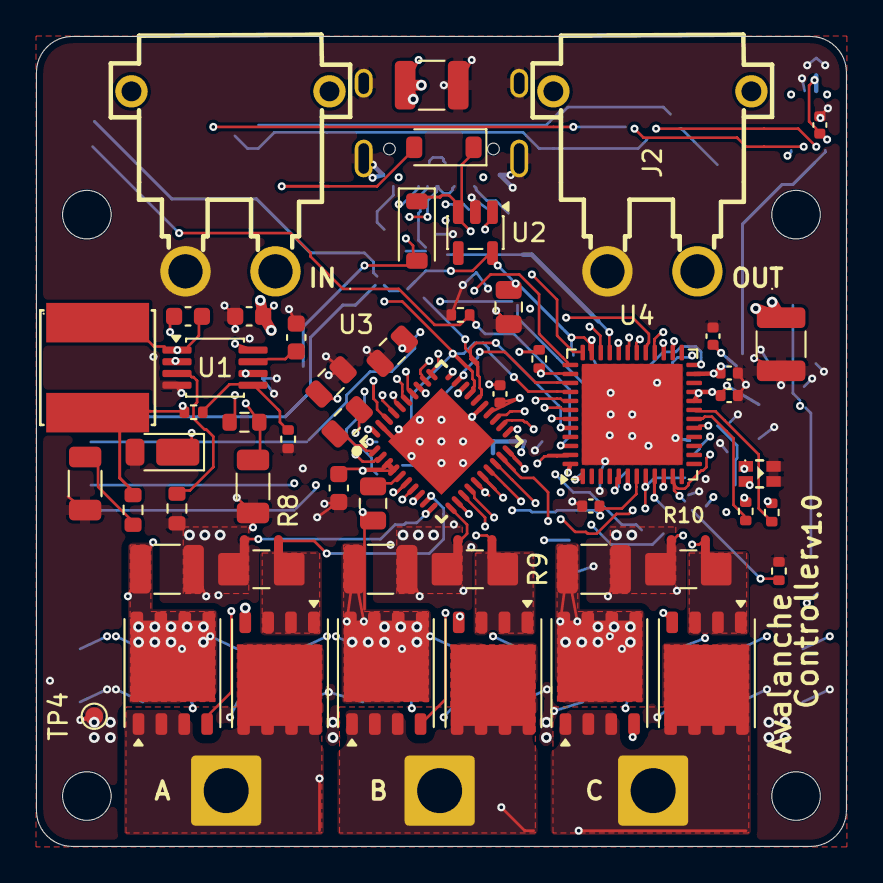
[picture p8: board foc_controller.kicad_pcb from above]

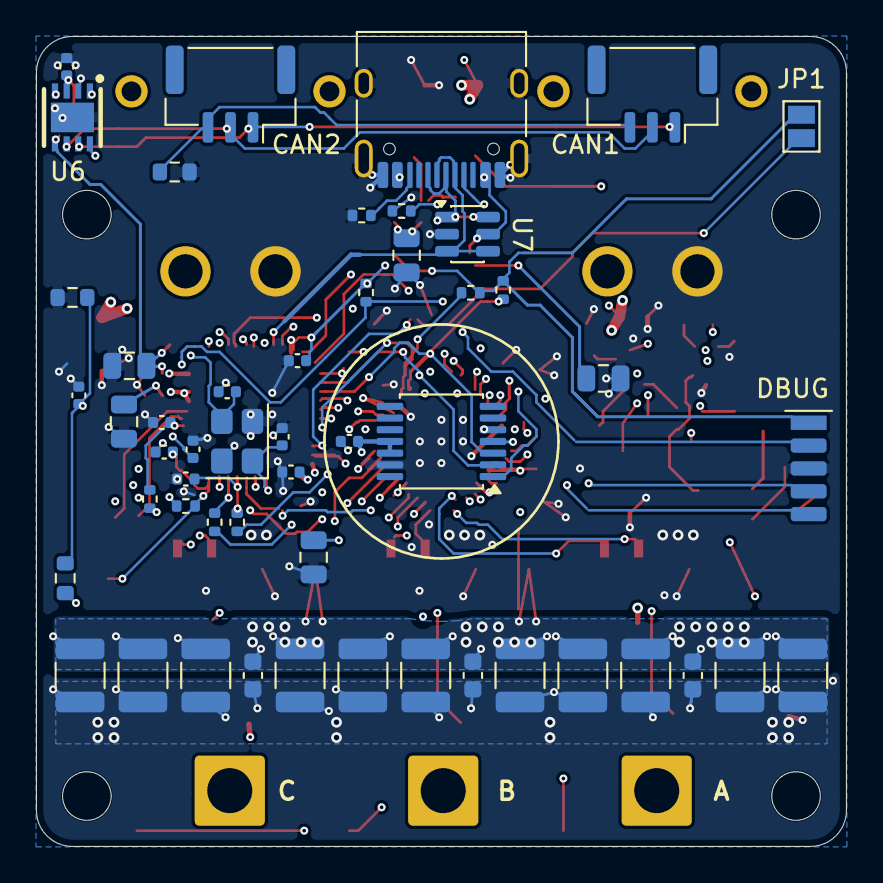
[picture p9: board foc_controller.kicad_pcb from below]

Board: 6 copper layers, 45.0 x 45.0 mm, 117 parts (51 on the bottom side), 77 nets.

Other parts of the board:
A: MOTOR_A; SolderWire-2sqmm_1x01_D2mm_OD3.9mm
B: MOTOR_B; SolderWire-2sqmm_1x01_D2mm_OD3.9mm
C: MOTOR_C; SolderWire-2sqmm_1x01_D2mm_OD3.9mm
CAN1: CAN IN; JST_GH_SM03B-GHS-TB_1x03-1MP_P1.25mm_Horizontal
CAN2: CAN OUT; JST_GH_SM03B-GHS-TB_1x03-1MP_P1.25mm_Horizontal
DBUG: SWD; SWD_Pads_1x05_P1.27mm_SMD
R25: 10k 1%; R_0402_1005Metric

Their connections:
+3V3: DBUG.1, R25.1; also elsewhere on the board
/Comms/CAN_GND: CAN1.3, CAN2.3; also elsewhere on the board
/Comms/CAN_H: CAN1.1, CAN2.1; also elsewhere on the board
/Comms/CAN_L: CAN1.2, CAN2.2; also elsewhere on the board
/DRV_nSCS: R25.2; also elsewhere on the board
/MCU/NRST: DBUG.5; also elsewhere on the board
/MCU/SWCLK: DBUG.2; also elsewhere on the board
/MCU/SWDIO: DBUG.4; also elsewhere on the board
/PHASE_A: A.1 (Pin_1_1); also elsewhere on the board
/PHASE_B: B.1 (Pin_1_1); also elsewhere on the board
/PHASE_C: C.1 (Pin_1_1); also elsewhere on the board
GND: DBUG.3; also elsewhere on the board
