mAzurkovic/foc/(commit log)

2026-10-13 Field-oriented control for a 7025 motor: Uno bring-up and Nucleo F446RE controller
    Bring-up sketches for the AS5048A encoder and the DRV8323RS and DRV8305
    driver boards on an Arduino Uno, then a 20 kHz controller on a
    NUCLEO-F446RE (nucleo_foc) with current, speed and position loops,
    cogging feed-forward and braking that dissipates energy in the windings.
    nucleo_foc defaults are from measurements on this motor: 0.030 ohm,
    5.5 uH, 2900 rpm/s per amp, speed loop 50 Hz, position loop 5 Hz.
2026-10-13 Measure and store the cogging table on the Nucleo; move earlier sketches to legacy/
    nucleo_foc gains a 'C' command that scans cogging torque at constant slow
    speed, one turn each way, into a 2048-entry table, uses it as the
    feed-forward and stores it in emulated EEPROM so it survives resets and
    uploads. Also adds adjustable observer bandwidth ('O') and status rate
    ('m'), with the speed loop held at least 5x below the current loop and
    the observer.
    Everything except nucleo_foc moves under legacy/. Adds a README with
    wiring, commands and the measured motor values.
2026-10-15 Plan position moves and use space-vector modulation
    'p' now plans a trapezoidal move (accelerate, cruise, brake to rest) and
    feeds the planned speed and acceleration forward; the position P gain only
    corrects the remaining error. Each move reports its planned and actual
    time. Space-vector modulation centres the three phases, giving 15 % more
    voltage within the duty limits needed for low-side current sensing, and
    the phase-voltage cap rises from 2 V to 3 V.
    README: planned moves, new limits, supply rating.
2026-10-19 Add requirements and electronics design for the custom controller board
    The PRD is turned into a BRD (specs/pmsm-controller/requirements.md) and
    an electronics design (design-electronics.md): STM32G474, DRV8353S with a
    standalone LM5008A buck, BSC026N08NS5 bridge, AS5047P encoder, CAN FD
    daisy chain over XT30 and JST-GH, with JLC part numbers and supporting
    components taken from each chip's datasheet.
2026-10-19 Add KiCad render/diff scripts and the JLCPCB MCP dependency
2026-10-19 Add KiCad schematic for the PMSM controller board
    Six hierarchical sheets (power, gate driver, bridge, MCU, encoder,
    comms) generated from design-electronics.md, with project symbols,
    footprints and 3D models in hw/lib and every part's datasheet in
    hw/datasheets. ERC 0. hw/review/schematic-check.md holds the
    datasheet pin cross-check, ratings vs stress, analyzer triage and
    SPICE results.
    Spec updates found during schematic capture: 80 V bulk caps, FR26
    hard trip at setting + 2 V, no snubber pads (layout + IDRIVE),
    SWD as unfitted debug pads.
2026-10-19 Remove requirement IDs from schematic notes
    Notes now state the reason in plain words so the schematic reads
    without the requirements document.
2026-10-19 Apply schematic review fixes and connector changes
    - Remove the RC snubber pads (ringing handled by layout and IDRIVE)
    and renumber R/C references to close the gap.
    - CAN connectors: JST-GH 3-pin (CANH, CANL, GND).
    - Power connectors: XT30PW-F female for both bus IN and OUT so the
    live side of every link is shrouded; polarity checked on a real
    part (pad 1 GND under the rounded end, pad 2 VBUS under the flat
    end). Male XT30 footprint, model and datasheet removed.
    - AS5047P CSn 10k pull-up so encoder inputs never float while the
    MCU is in reset or ROM DFU.
    - LM5008A RT 180k -> 240k: on-time stays >= 400 ns at 54 V across
    the TON spread.
    - Every BOM line checked in stock against JLC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
2026-10-20 Place the 45 x 45 mm two-sided board and review its risks
    Ceramic-only bulk caps, per-phase caps under each FET pair, one FET row,
    corner M3 holes, USB-C and CAN on the motor side, XT30s closer together.
    Encoder clearance 10 mm, 10 A RMS rating with no heatsink. Placement
    fixes from the risk review: BOOT0 pad away from VBUS, 3 mm clear around
    the XT30 power joints, edge caps parallel to the edge. Specs, layout
    check and risk review updated; fuse and regen clamp now required
    off-board parts.
2026-10-27 Route the 6-layer board and finalize parts for ordering
    The 45 x 45 mm board is fully routed on six layers (F / GND / SIG /
    SIG / PWR / B, 2 oz outer, 1 oz inner): DRC 0 errors, 0 unconnected,
    schematic parity 0. Four layers could not route the DRV-to-MCU links
    without moving the power or input stage.
    - Encoder shares the DRV8353's SPI3 bus, as on the PoC; PA5-PA7 are
    unused. R25 pulls DRV nSCS up, since the DRV's logic inputs have an
    internal pull-down. The SDO / MISO pin-type warning is an ERC
    exclusion with a note.
    - MCU is now the STM32G473CEU6: the G474 without the unused HRTIM,
    checked pin for pin against both datasheets, in stock and cheaper.
    - Male XT30PW-M power connectors,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
